Acerola-OvO/Tactile-Sensors-for-Robotic-Manipulators/LICENSES/README.md

# Licensing notes

The derived Arduino firmware retains the upstream 3D-ViTac MIT notice in `3D-ViTac-MIT.txt` and in the source file itself.

A repository-wide license has not yet been selected for Xu Cheng's original documentation, photographs, and refactored visualization code. Select one before broad redistribution. The hardware manufacturing files are presented with attribution to the reference design; verify the upstream hardware license before treating them as freely relicensable design sources.
