Acerola-OvO/Tactile-Sensors-for-Robotic-Manipulators/hardware/schematics/sensor_reading_board_redrawn.pdf

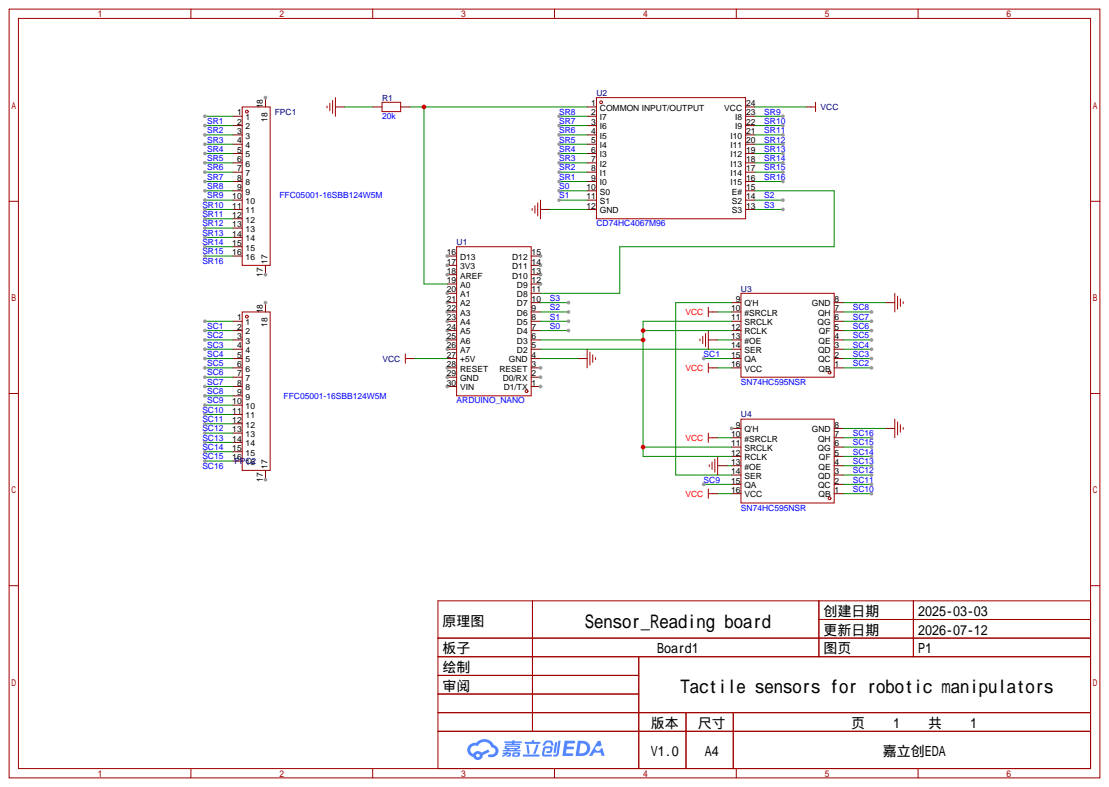
[picture p42: page 1]

原理图 | Sensor_Reading board | 创建日期 | 2025-03-03

更新日期 | 2026-07-12

板子 | Board1 | 图页 | P1
绘制 | | Tactile sensors for robotic manipulators
审阅

V1.0 | A4 | 嘉立创EDA
